corbinstreehouse/LEDDigitalCyrWheel/CyrWheel_PCB/LEDCyrWheel.pdf

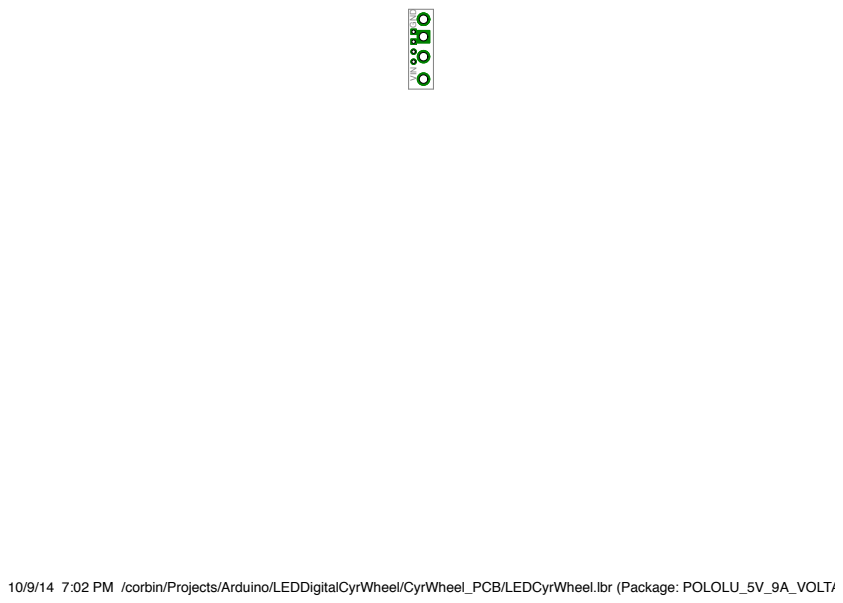
[picture p1: page 1]

10/9/14 7:02 PM /corbin/Projects/Arduino/LEDDigitalCyrWheel/CyrWheel_PCB/LEDCyrWheel.lbr (Package: POLOLU_5V_9A_VOLTAGE_REGULATOR) GND VIN
