corbinstreehouse/LEDDigitalCyrWheel/CyrWheel_PCB/LEDCyrWheel.brd

## EAGLE design CyrWheel_PCB/LEDCyrWheel.brd (2016-02-13)

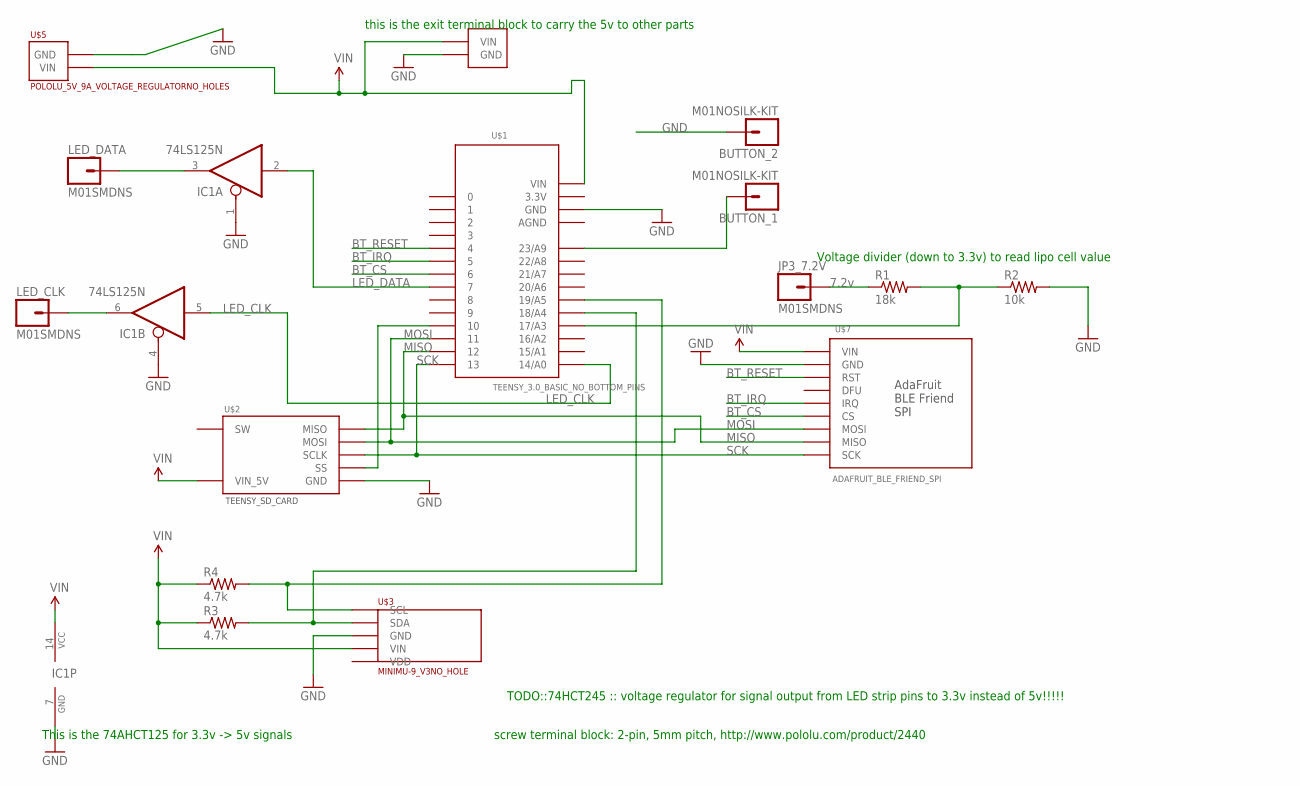
[picture p2: schematic LEDCyrWheel.sch]

Parts:
BUTTON_1, BUTTON_2: M01NOSILK-KIT; 1X01NS-KIT
IC1: 74LS125N; DIL14
JP3_7.2V: M01SMDNS; 1X01NS; VOLTAGE 7.2v
LED_CLK: M01SMDNS; 1X01NS
LED_DATA: M01SMDNS; 1X01NS
R1: 18k; AXIAL-0.4
R2: 10k; AXIAL-0.4
R3, R4: 4.7k; AXIAL-0.4
U$1: TEENSY_3.0_BASIC_NO_BOTTOM_PINS
U$2: TEENSY_SD_CARD
U$3: MINIMU-9_V3NO_HOLE; MINIMU-9_V3_NO_HOLE
U$5: POLOLU_5V_9A_VOLTAGE_REGULATORNO_HOLES; POLOLU_5V_9A_VOLTAGE_REGULATOR_NO_HOLES
U$6: VIN_GND_HOLE; VIN_HOLE
U$7: ADAFRUIT_BLE_FRIEND_SPI

Connections:
3.3V: U$1.3.3V
AGND: U$1.AGND
BT_CS: U$1.6, U$7.CS
BT_IRQ: U$1.5, U$7.IRQ
BT_RESET: U$1.4, U$7.RST
GND: BUTTON_2.1, IC1.1 (OE), IC1.4 (OE), IC1.7 (GND), R2.P$2 (2), U$1.GND, U$2.GND, U$3.GND, U$5.GND, U$5.GND2 (GND), U$5.GND3 (GND), U$6.GND, U$7.GND
LED_CLK: IC1.5 (I), U$1.14/A0
LED_DATA: IC1.2 (I), U$1.7
MISO: U$1.12, U$2.MISO, U$7.MISO
MOSI: U$1.11, U$2.MOSI, U$7.MOSI
unnamed: U$1.10, U$2.SS
unnamed: IC1.6 (O), LED_CLK.1
unnamed: BUTTON_1.1, U$1.23/A9
N_PIN17: R1.P$2 (2), R2.P$1 (1), U$1.17/A3
N_PIN_2_LED_STRIP: IC1.3 (O), LED_DATA.1
SCK: U$1.13, U$2.SCLK, U$7.SCK
SCL: R4.P$2 (2), U$1.19/A5, U$3.SCL
SDA: R3.P$2 (2), U$1.18/A4, U$3.SDA
VIN: IC1.14 (VCC), R3.P$1 (1), R4.P$1 (1), U$1.VIN, U$2.VIN (VIN_5V), U$3.VIN, U$5.VIN, U$5.VIN2 (VIN), U$5.VIN3 (VIN), U$6.VIN, U$7.VIN
VIN_7_2V: JP3_7.2V.1, R1.P$1 (1)

Notes on the sheet:
screw terminal block: 2-pin, 5mm pitch, http://www.pololu.com/product/2440
this is the exit terminal block to carry the 5v to other parts
Voltage divider (down to 3.3v) to read lipo cell value
TODO::74HCT245 :: voltage regulator for signal output from LED strip pins to 3.3v instead of 5v!!!!!
This is the 74AHCT125 for 3.3v -> 5v signals

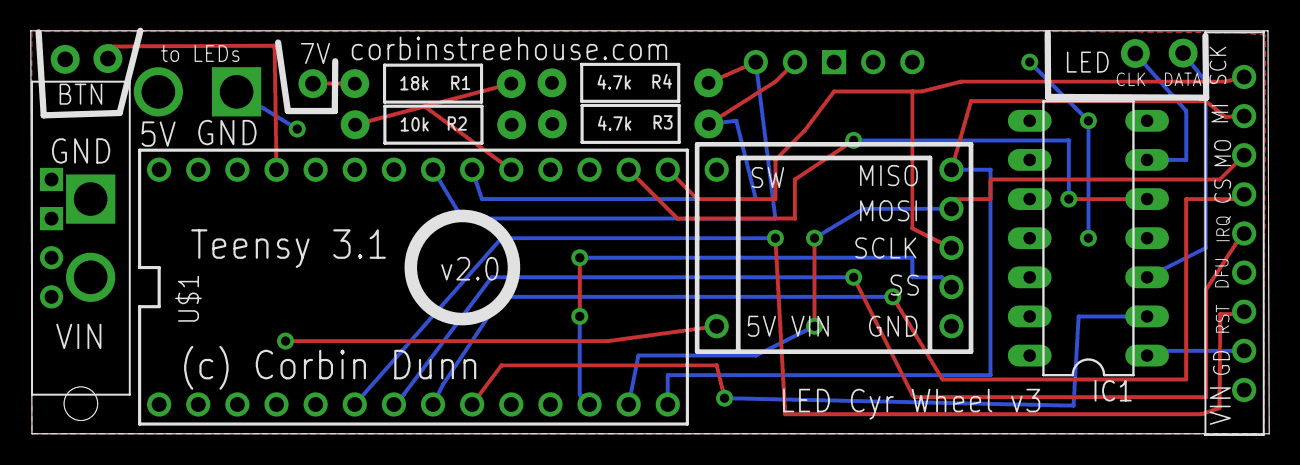
[picture p3: board LEDCyrWheel.brd from above]

Board: 2 copper layers, 80.4 x 26.2 mm, 16 parts (1 on the bottom side), 18 nets.
