corbinstreehouse/LEDDigitalCyrWheel/LEDDigitalCyrWheel/CWPatternSequenceManager.cpp

//
//  CWPatternSequence.cpp
//  LEDDigitalCyrWheel
//
//  Created by corbin dunn on 2/5/14.
//
//

#include "CWPatternSequenceManager.h"
#include "LEDPatterns.h"
#include "LEDDigitalCyrWheel.h"
#include "LEDCommon.h"
#include "SdFat.h"
#include "EEPROM.h"
#if BLUETOOTH
#include "CDWheelBluetoothController.h"
#endif

#define RECORD_INDICATOR_FILENAME "record.txt" // If this file exists, we record data in other files.

#if DEBUG
    #warning "DEBUG Code is on!!"
#include "SdFatUtil.h"
#endif

#define FILENAME_MAX_LENGTH MAX_PATH
#define BURN_INITIAL_STATE 0 // Set to 1 and run once


#if !PATTERN_EDITOR
static const char *g_sequencePath = "/"; // warning..changing this may require different buffers
#endif

char *getExtension(char *filename) {
    char *ext = strchr(filename, '.');
    if (ext) {
        ext++; // go past the dot...
        return ext;
    } else {
        return NULL;
    }
}

CWPatternSequenceManager::CWPatternSequenceManager() : m_ledPatterns(STRIP_LENGTH), m_changeHandler(NULL), m_patternItems(NULL), m_numberOfPatternItems(0)
{
    bzero(&m_rootFileInfo, sizeof(CDPatternFileInfo));
    m_currentPatternItemIndex = -1;
    m_currentFileInfo = NULL;
    m_shouldIgnoreButtonClickWhenTimed = true; // TODO: make this an option per sequence...
    m_timedPatternStartTime = 0;
    ASSERT(sizeof(CDPatternItemHeader) == PATTERN_HEADER_SIZE_v5); // make sure I don't screw stuff up by chaning the size and not updating things again
    ASSERT(sizeof(LEDPatternOptions) == PATTERN_OPTIONS_SIZE_v5); // make sure I don't screw stuff up by chaning the size and not updating things again
    
    m_lowBattery = false;
}

static void freePatternFileInfoAndChildren(CDPatternFileInfo *fileInfo) {
    // Just reset the parent on the default item
    if (fileInfo) {
        if (fileInfo->children) {
            for (int i = 0; i < fileInfo->numberOfChildren; i++) {
                freePatternFileInfoAndChildren(&fileInfo->children[i]);
            }
            free(fileInfo->children);
#if DEBUG
            fileInfo->children = NULL;
#endif
        }
    }
}

static void freePatternFileInfoChildren(CDPatternFileInfo *fileInfo) {
    if (fileInfo) {
        if (fileInfo->children) {
            for (int i = 0; i < fileInfo->numberOfChildren; i++) {
                freePatternFileInfoAndChildren(&fileInfo->children[i]);
            }
            free(fileInfo->children);
            fileInfo->children = NULL; // leave in!!
        }
    }
}

void CWPatternSequenceManager::freeRootFileInfo() {
    freePatternFileInfoAndChildren(&m_rootFileInfo);
    m_currentFileInfo = NULL;
}

#if PATTERN_EDITOR
CWPatternSequenceManager::~CWPatternSequenceManager() {
    m_baseURL = nil;
//    m_patternDirectoryURL = nil;
    freePatternItems();
    freeRootFileInfo();
}
    
void CWPatternSequenceManager::setCyrWheelView(CDCyrWheelView *view) {
    m_ledPatterns.setCyrWheelView(view);
}

void CWPatternSequenceManager::setBaseURL(NSURL *url) {
    m_baseURL = url;
    loadSequencesFromRootDirectory();
}

//void CWPatternSequenceManager::setPatternDirectoryURL(NSURL *url) {
//    m_patternDirectoryURL = url;
//}

#endif

void CWPatternSequenceManager::loadDefaultSequence() {
    DEBUG_PRINTLN("       --- loading default sequence because the name was NULL --- ");
    freePatternItems();

    m_numberOfPatternItems = LEDPatternTypeCount;
    m_shouldIgnoreButtonClickWhenTimed = false;
    
    // After the header each item follows
    m_patternItems = (CDPatternItemHeader *)malloc(m_numberOfPatternItems * sizeof(CDPatternItemHeader));
    
    int i = 0;
    for (int p = LEDPatternTypeMin; p < LEDPatternTypeCount; p++) {
        if (p == LEDPatternTypeDoNothing || p == LEDPatternTypeFadeIn || p == LEDPatternTypeImageReferencedBitmap || p == LEDPatternTypeImageEntireStrip_UNUSED || p == LEDPatternTypeFadeOut || p == LEDPatternTypeCrossfade || p == LEDPatternTypeCount || p == LEDPatternTypeBitmap) {
            continue; // skip a few
        }
        bzero(&m_patternItems[i], sizeof(CDPatternItemHeader));
        
        m_patternItems[i].patternType = (LEDPatternType)p;
        m_patternItems[i].patternEndCondition = CDPatternEndConditionOnButtonClick;
        m_patternItems[i].duration = 2000; //  2 seconds
        m_patternItems[i].patternDuration = 2000;
        // bzero takes care of these
//        m_patternItems[i].patternOptions = 0;
//        m_patternItems[i].dataLength = 0;
        m_patternItems[i].shouldSetBrightnessByRotationalVelocity = 0; // Nope.
//        m_patternItems[i].color = (uint8_t)random(255) << 16 | (uint8_t)random(255) << 8 | (uint8_t)random(255); //        0xFF0000; // red
//        m_patternItems[i].color = (uint8_t)random(255) << 16 | (uint8_t)random(255) << 8 | (uint8_t)random(255); //        0xFF0000; // red
        switch (random(3)) { case 0: m_patternItems[i].color = 0xFF0000; break; case 1: m_patternItems[i].color = 0x00FF00; break; case 2: m_patternItems[i].color = 0x0000FF; break; }
//        m_patternItems[i].dataOffset = 0;
        i++;
    }
    m_numberOfPatternItems = i;
    DEBUG_PRINTF(" --- default pattern count m_numberOfPatternItems: %d\r\n", m_numberOfPatternItems);
    sequenceChanged();
}

static inline bool verifyHeader(CDPatternSequenceHeader *h) {
    // header, and version 0
    DEBUG_PRINTF("checking header, v: %d , expected :%d\r\n", h->version, SEQUENCE_VERSION_v5);
    return h->marker[0] == 'S' && h->marker[1] == 'Q' && h->marker[2] == 'C';
}

void CWPatternSequenceManager::freePatternItems() {
    if (m_patternItems) {
        DEBUG_PRINTLN(" --- free pattern Items");
        for (int i = 0; i < m_numberOfPatternItems; i++) {
            // If it has data, we have to free it
            if (m_patternItems[i].filename) {
                DEBUG_PRINTF("FREEING filename: %s\r\n", m_patternItems[i].filename);
                free(m_patternItems[i].filename);
            }
        }
        free(m_patternItems);
        m_patternItems = NULL;
        m_numberOfPatternItems = 0; // can be removed
    }
    
}

CDPatternItemHeader CWPatternSequenceManager::makeFlashPatternItem(CRGB color) {
    CDPatternItemHeader result;
    result.patternType = LEDPatternTypeBlink;
    result.duration = 500;
    result.patternDuration = 500;
    result.color = color;
    result.patternEndCondition = CDPatternEndConditionOnButtonClick;
    result.filename = NULL;
    return result;
}

void CWPatternSequenceManager::sequenceChanged() {
    // Send the changed note at the end
    sendWheelChanged(CDWheelChangeReasonSequenceChanged);
}

void CWPatternSequenceManager::makeSequenceFlashColor(CRGB color) {
    freePatternItems();
    
    m_numberOfPatternItems = 1;
    m_patternItems = (CDPatternItemHeader *)malloc(sizeof(CDPatternItemHeader) * m_numberOfPatternItems);
    m_patternItems[0] = makeFlashPatternItem(color);

    m_currentPatternItemIndex = 0;
    
    sequenceChanged();
}

// Almost the same as the above..
void CWPatternSequenceManager::makePatternsBlinkColor(CRGB color) {
    m_ledPatterns.setPatternDuration(500);
    m_ledPatterns.setPatternColor(color);
    m_ledPatterns.setPatternType(LEDPatternTypeBlink);
}

void CWPatternSequenceManager::setDynamicPatternType(LEDPatternType type, uint32_t patternDuration, CRGB color) {
    m_dynamicPattern = true;
    
    CDPatternItemHeader header;
    bzero(&header, sizeof(CDPatternItemHeader));
    header.patternType = type;
    header.duration = patternDuration; // Ignored since we are to play till button click
    header.patternDuration = patternDuration;
    header.color = color;
    // I want certain patterns to loop back to the start (here) and repeat after the tick; this allows "single use" patterns to repeat
    if (LEDPatterns::PatternDurationShouldBeEqualToSegmentDuration(type)) {
        header.patternEndCondition = CDPatternEndConditionAfterDuration;
    } else {
        // Just runs indefinitely...
        header.patternEndCondition = CDPatternEndConditionOnButtonClick;
    }
    header.filename = NULL;
    setSingleItemPatternHeader(&header);
    m_currentPatternItemIndex = 0;
    resetStartingTime();
    loadCurrentPatternItem();
}

void CWPatternSequenceManager::setDynamicBitmapPatternType(const char *filename, uint32_t patternDuration, LEDBitmapPatternOptions bitmapOptions) {
    CDPatternItemHeader result;
    bzero(&result, sizeof(CDPatternItemHeader));
    // TODO: might be better to find it in the list!! and then not set m_dynamicPattern!
    m_dynamicPattern = true;
    result.patternType = LEDPatternTypeImageReferencedBitmap;
    result.color = CRGB::Red;
    result.duration = 50;
    result.patternDuration = patternDuration;
    result.patternEndCondition = CDPatternEndConditionOnButtonClick;
    result.patternOptions = LEDPatternOptions(bitmapOptions);
    // filename is later freed automatically when not NULL
    result.filename = (char*)malloc(strlen(filename) + 1);
    strcpy(result.filename, filename);

    setSingleItemPatternHeader(&result);
    m_shouldIgnoreButtonClickWhenTimed = false; // This could be made an option that is settable/dynamically changable.
    m_currentPatternItemIndex = 0;
    
    // TODO: it would be better to find this item in the parent and set it...
    m_dynamicPattern = true;
    resetStartingTime();
    loadCurrentPatternItem();
}

static void _appendFilename(const char *rootDirName, const char *filename, char *fullFilenamePath, size_t size) {
    char *nameLocation = fullFilenamePath;
    // copy the directory for the patterns
    strcpy(nameLocation, rootDirName);
    nameLocation += strlen(rootDirName);
    if (nameLocation[-1] != '/') {
        nameLocation[0] = '/';
        nameLocation++;
    }
    strcpy(nameLocation, filename);
    nameLocation += strlen(filename);
    nameLocation[0] = NULL;
}

void CWPatternSequenceManager::playSequenceWithFilename(const char *filename) {
    // relative filename
    char fullFilenamePath[MAX_PATH];
    _appendFilename(_getRootDirectory(), filename, fullFilenamePath, MAX_PATH);
    
    // open the file
    FatFile sequenceFile = FatFile(fullFilenamePath, O_READ);
#if DEBUG
    DEBUG_PRINTF(" pattern sequence OPENED file:");
    sequenceFile.printName();
    DEBUG_PRINTLN();
#endif
    loadAsSequenceFromFatFile(&sequenceFile);
    sequenceFile.close();
    firstPatternItem();
}

void CWPatternSequenceManager::flashThreeTimes(CRGB color, uint32_t delayAmount) {
    m_ledPatterns.flashThreeTimes(color);
}

// if stackBufferSize == 0, it always allocates (yeah, bad mem mangement techniques)
// This walks to the parent, adds its path, and then adds the child's path to get a complete path
// returns SFN
size_t _recursiveGetFullpathName(const char *rootDirName, const CDPatternFileInfo *fileInfo, char *buffer, size_t size, size_t startingOffset, bool useSFN) {
    if (fileInfo->parent) {
        startingOffset = _recursiveGetFullpathName(rootDirName, fileInfo->parent, buffer, size, startingOffset, useSFN);
    }
    // Add in our path, include seperators
    if (startingOffset > 0 && buffer[startingOffset-1] != '/') {
        buffer[startingOffset] = '/';
        startingOffset++;
        buffer[startingOffset] = 0; // So we can open it...
    }
    
    char *nameLocation = &buffer[startingOffset];
    if (fileInfo->parent == NULL) {
        // Root
        strcpy(nameLocation, rootDirName);
    } else {
        FatFile parentDirectory = FatFile(buffer, O_READ);
        FatFile file;
        if (file.open(&parentDirectory, fileInfo->dirIndex, O_READ)) {
    #if DEBUG
//            DEBUG_PRINTF("  opened and copying the name. buffer: %s, name: ", buffer);
//            file.printName();
//            DEBUG_PRINTF("\r\n");
    #endif
            if (useSFN) {
                if (!file.getSFN(nameLocation)) {
                    // errors?
                }
            } else {
                if (!file.getName(nameLocation, size-startingOffset)) {
                    // errors?
                }
            }
            file.close();
        } else {
            DEBUG_PRINTF("  open failed!!!!!\r\n");
        }
        parentDirectory.close();
    }
    return startingOffset + strlen(nameLocation);
}


static void _getFullpathName(const char *rootDirName, const CDPatternFileInfo *fileInfo, char *buffer, size_t size, bool useSFN = true) {
    buffer[0] = 0;
//    DEBUG_PRINTF(" start to get name for dir: %d \r\n", fileInfo->dirIndex);
    _recursiveGetFullpathName(rootDirName, fileInfo, buffer, size, 0, useSFN);
//    DEBUG_PRINTF(" computed filename: %s\r\n", buffer);
}

void CWPatternSequenceManager::loadAsBitmapFileInfo(CDPatternFileInfo *fileInfo) {
    CDPatternItemHeader result;
    result.patternType = LEDPatternTypeBitmap; // Easy testing: LEDPatternTypeTheaterChase;
    result.color = CRGB::Red;
    result.duration = 50;
    bool isPOV = false;
    // POV patterns will be as fast as they can go (value == 0)... but that looks terrible for non POV patterns
    // Harcode certain directory names as being POV
    // Load our parent directory name to find out
    uint32_t defaultDuration = 32; // slowish
    if (fileInfo->parent) {
        // I could probably do this faster..
        char filenameBuffer[FILENAME_MAX_LENGTH];
        _getFullpathName(_getRootDirectory(), fileInfo->parent, filenameBuffer, FILENAME_MAX_LENGTH);
        FatFile parentDirectory = FatFile(filenameBuffer, O_READ);
        if (parentDirectory.getName(filenameBuffer, FILENAME_MAX_LENGTH)) {
            // corbin, other dirs!! pixels, etc.
            
            if (strcmp(filenameBuffer, "Pictures") == 0 || strcmp(filenameBuffer, "Figures") == 0) {
                defaultDuration = 0; // POV duration
                isPOV = true;
            }
        }
    }
    
    result.patternDuration = defaultDuration;
    result.patternEndCondition = CDPatternEndConditionOnButtonClick;
    bool shouldInterpolateToNextRow = false; // TODO:?? default value for these??
    result.patternOptions = LEDPatternOptions(LEDBitmapPatternOptions(false, m_defaultShouldStretchBitmap, shouldInterpolateToNextRow, isPOV));
    result.filename = NULL;
    
    setSingleItemPatternHeader(&result); // Sends sequenceChanged
    m_shouldIgnoreButtonClickWhenTimed = false; // This could be made an option that is settable/dynamically changable.
}

uint32_t CWPatternSequenceManager::getCurrentPatternSpeed() {
    CDPatternItemHeader *header = getCurrentItemHeader();
    return header ? header->patternDuration : 0;
}

void CWPatternSequenceManager::setCurrentPatternColor(CRGB color) {
    CDPatternItemHeader *header = getCurrentItemHeader();
    if (header) {
        if (header->color != color) {
            header->color = color;
            m_ledPatterns.setPatternColor(color);
            sendWheelChanged(CDWheelChangeReasonPatternChanged);
        }
    }
}

void CWPatternSequenceManager::setCurrentPattenOptions(LEDPatternOptions options) {
    CDPatternItemHeader *header = getCurrentItemHeader();
    if (header) {
        if (header->patternOptions.raw != options.raw) {
            header->patternOptions = options;
            m_ledPatterns.setPatternOptions(options);
            sendWheelChanged(CDWheelChangeReasonPatternChanged);
        }
    }
}

void CWPatternSequenceManager::setCurrentPattenShouldSetBrightnessByRotationalVelocity(bool value) {
    CDPatternItemHeader *header = getCurrentItemHeader();
    if (header) {
        if (header->shouldSetBrightnessByRotationalVelocity != value) {
            header->shouldSetBrightnessByRotationalVelocity = value;
            updateBrightness();
            sendWheelChanged(CDWheelChangeReasonPatternChanged);
        }
    }
}


void CWPatternSequenceManager::setCurrentPatternSpeed(uint32_t speedInMs) {
    CDPatternItemHeader *header = getCurrentItemHeader();
    if (header) {
        if (header->patternDuration != speedInMs) {
            header->patternDuration = speedInMs;
            m_ledPatterns.setPatternDuration(speedInMs);
            sendWheelChanged(CDWheelChangeReasonPatternChanged);
        }
    }
}


void CWPatternSequenceManager::loadAsSequenceFromFatFile(FatFile *sequenceFile) {
    freePatternItems();
    m_dynamicPattern = false;
    // This is reading the file format I created..
    // Header first
    CDPatternSequenceHeader patternHeader;
    if (sequenceFile->available()) {
        sequenceFile->read((char*)&patternHeader, sizeof(CDPatternSequenceHeader));
    } else {
        bzero(&patternHeader, sizeof(CDPatternSequenceHeader));
    }
    
    // Verify it
    if (verifyHeader(&patternHeader)) {
        if (patternHeader.version == SEQUENCE_VERSION_v5) {
            // Free existing stuff
            ASSERT(m_patternItems == NULL);
            
            m_numberOfPatternItems = patternHeader.patternCount;
            m_shouldIgnoreButtonClickWhenTimed = patternHeader.ignoreButtonForTimedPatterns;
            
            ASSERT(sizeof(CDPatternItemHeader) == PATTERN_HEADER_SIZE_v5); // MAKE SURE IT IS RIGHT..
            DEBUG_PRINTF("now reading %d items, headerSize: %d\r\n", m_numberOfPatternItems, sizeof(CDPatternItemHeader));
            
            // After the header each item follows
            m_patternItems = (CDPatternItemHeader *)calloc(m_numberOfPatternItems, sizeof(CDPatternItemHeader));
            //            memset(m_patternItems, 0, numBytes); // shouldn't be needed, but do it anyways
            
            for (int i = 0; i < m_numberOfPatternItems; i++ ){
                DEBUG_PRINTF("reading item %d\r\n", i);
                sequenceFile->read((char*)&m_patternItems[i], sizeof(CDPatternItemHeader));
                DEBUG_PRINTF("Header, type: %d, duration: %d, patternDuration %d\r\n", m_patternItems[i].patternType, m_patternItems[i].duration, m_patternItems[i].patternDuration);
                // Verify it
                bool validData = m_patternItems[i].patternType >= LEDPatternTypeMin && m_patternItems[i].patternType < LEDPatternTypeCount;
                ASSERT(validData);
                if (!validData) {
                    // fill it in with something..
                    m_patternItems[i] = makeFlashPatternItem(CRGB::Red);
                } else {
                    // I guess a 0 duration is okay..it will just blink it..
                    // After the header, is the (optional) image data
                    
                    // Read in the filename, if it is there..
                    uint32_t filenameLength = m_patternItems[i].filenameLength; // We use a union, so we have to save the length first
                    if (filenameLength > 0) {
                        ASSERT(filenameLength <= MAX_PATH);
                        size_t filenameSize = sizeof(char) * filenameLength + 1; // Space for the name plus one for the NULL
                        m_patternItems[i].filename = (char*)malloc(filenameSize);
                        // Read into the filename buffer we allocated
                        sequenceFile->read(m_patternItems[i].filename, filenameSize);
                    } else {
                        m_patternItems[i].filename = NULL; //
                    }
                }
            }
            DEBUG_PRINTLN("DONE");
        } else {
            // We don't support this version... flash purple
            DEBUG_PRINTLN("wrong version!");
            makeSequenceFlashColor(CRGB::Purple);
        }
    } else {
        // Bad data...flash yellow
        DEBUG_PRINTLN("bad sequence file!");
        makeSequenceFlashColor(CRGB::Yellow);
    }
    sequenceChanged();
}

void CWPatternSequenceManager::loadAsSequenceFileInfo(CDPatternFileInfo *fileInfo) {
    ASSERT(fileInfo->patternFileType == CDPatternFileTypeSequenceFile);
    
    char fullFilenamePath[MAX_PATH];
    _getFullpathName(_getRootDirectory(), fileInfo, fullFilenamePath, MAX_PATH);
    
    DEBUG_PRINTF("  loadAsSequenceFileInfo: %d at %s\r\n", fileInfo->dirIndex, fullFilenamePath);
    
    // open the file
    FatFile sequenceFile = FatFile(fullFilenamePath, O_READ);
#if DEBUG
    DEBUG_PRINTF(" OPENED file:");
    sequenceFile.printName();
    DEBUG_PRINTLN();
#endif

    loadAsSequenceFromFatFile(&sequenceFile);

    sequenceFile.close();
}

void CWPatternSequenceManager::loadSequenceInMemoryFromFatFile(FatFile *sequenceFile) {
    m_currentPatternItemIndex = -1; // Set this first so that the sendWheelChanged doesn't allow the caller to acccess anything
    loadAsSequenceFromFatFile(sequenceFile);
    firstPatternItem();
}

void CWPatternSequenceManager::changeToDirectory(const char *dir) {
    // TODO: implement.. right now we go to root..
    m_currentFileInfo = NULL;
    _ensureCurrentFileInfo();
}

void CWPatternSequenceManager::loadFileInfo(CDPatternFileInfo *fileInfo) {
    ASSERT(fileInfo != NULL);
    ASSERT(fileInfo->patternFileType != CDPatternFileTypeDirectory);

//    m_currentPatternItemsAreDynamic = false;
    // in case we get the root for some reason (shouldn't happen!)
    if (fileInfo == &m_rootFileInfo) {
        loadDefaultSequence();
        return;
    }
    
    freePatternItems();
    
    m_dynamicPattern = false;
    
    switch (fileInfo->patternFileType) {
        case CDPatternFileTypeSequenceFile: {
            loadAsSequenceFileInfo(fileInfo);
            break;
        }
        case CDPatternFileTypeBitmapImage: {
            loadAsBitmapFileInfo(fileInfo);
            break;
        }
        case CDPatternFileTypeDefaultSequence: {
            loadDefaultSequence();
            break;
        }
        default: {
            makeSequenceFlashColor(CRGB::Red); // error of some sort
            sequenceChanged();
            break;
        }
    }
}

// TODO: rewrite this
//bool CWPatternSequenceManager::deleteSequenceAtIndex(int index) {
//    bool result = false;
//    int lastIndex = _currentSequenceIndex;
//    if (index >= 0 && index < _numberOfAvailableSequences) {
//        char *name = getSequenceNameAtIndex(index);
//        if (name != g_defaultFilename) {
//#define STACK_BUFFER_SIZE 32
//            char stackBuffer[STACK_BUFFER_SIZE];
//            char *filename = getFullpathName(name, stackBuffer, STACK_BUFFER_SIZE);
//            DEBUG_PRINTF("deleting %s\n", filename);
//            
//            result = SD.remove(filename);
//            
//            if (filename != stackBuffer) {
//                free(filename);
//            }
//            if (lastIndex >= index) {
//                lastIndex--;
//            }
//        }
//    }
//    
//    if (result) {
//        loadSequencesFromRootDirectory();
//        if (_currentSequenceIndex != lastIndex) {
//            loadCurrentSequence();
//        }
//    }
//    return result;
//}

void CWPatternSequenceManager::loadFirstSequence() {
    
    setCurrentSequenceAtIndex(0);
//    _currentSequenceIndex = 0;
//    loadCurrentSequence(); // validates the index here
}

CDPatternFileInfo *CWPatternSequenceManager::_findFirstLoadableChild(CDPatternFileInfo *fileInfo, bool forwards) {
    if (fileInfo->children == NULL && fileInfo->patternFileType == CDPatternFileTypeDirectory) {
        // Lazy load of children
        loadPatternFileInfoChildren(fileInfo);
    }
    if (fileInfo->children) {
        if (forwards) {
            for (int i = 0; i < fileInfo->numberOfChildren; i++) {
                CDPatternFileInfo *potentialChild = _findFirstLoadable(&fileInfo->children[i], forwards);
                if (potentialChild) {
                    return potentialChild;
                }
            }
        } else {
            for (int i = fileInfo->numberOfChildren - 1; i >= 0; i--) {
                CDPatternFileInfo *potentialChild = _findFirstLoadable(&fileInfo->children[i], forwards);
                if (potentialChild) {
                    return potentialChild;
                }
            }
        }
    }
    return NULL;
}

CDPatternFileInfo *CWPatternSequenceManager::_findFirstLoadable(CDPatternFileInfo *fileInfo, bool forwards) {
    if (fileInfo->patternFileType != CDPatternFileTypeDirectory) {
        return fileInfo; // This item is loadable
    }
    return _findFirstLoadableChild(fileInfo, forwards);
}

CDPatternFileInfo *CWPatternSequenceManager::_findNextLoadableChild(CDPatternFileInfo *fromChild, bool forwards) {
    CDPatternFileInfo *result = NULL;
    CDPatternFileInfo *parent = fromChild->parent;
    if (parent) {
        // Go through the parent's children, finding the first loadable one
        int end, inc;
        if (forwards) {
            end = parent->numberOfChildren;
            inc = 1;
        } else {
            end = -1;
            inc = -1;
        }
        int start = fromChild->indexInParent + inc;

        for (int i = start; i != end; i += inc) {
            result = _findFirstLoadable(&parent->children[i], forwards);
            if (result) {
                return result;
            }
        }
        // We went through all the parent's children, and nothing is loadable. Go to our parent's next sibling
        result = _findNextLoadableChild(parent, forwards);
    } else {
        // We have reached the root; this should always have something to return; if it doesn't, we return the root, which should be loadable..
        result = _findFirstLoadableChild(fromChild, forwards);
        if (result == NULL) {
            DEBUG_PRINTLN("************* No loadable children?????");
            result = parent;
        }
    }
    return result;
}

void CWPatternSequenceManager::loadNextDirectory() {
    m_currentFileInfo = _findNextLoadableChild(m_currentFileInfo->parent, true);
    loadCurrentSequence();
}

void CWPatternSequenceManager::loadPriorDirectory() {
    m_currentFileInfo = _findNextLoadableChild(m_currentFileInfo->parent, false);
    loadCurrentSequence();
}


void CWPatternSequenceManager::_ensureCurrentFileInfo() {
    if (m_currentFileInfo == NULL) {
        m_currentFileInfo = _findFirstLoadableChild(&m_rootFileInfo, true);
        if (m_currentFileInfo == NULL) {
            m_currentFileInfo = &m_rootFileInfo;
        }
    }
}

void CWPatternSequenceManager::setCurrentSequenceAtIndex(int index) {
    _ensureCurrentFileInfo();
    if (m_currentFileInfo) {
        CDPatternFileInfo *parent = m_currentFileInfo->parent;
        if (parent && index < parent->numberOfChildren) {
            m_currentFileInfo = &parent->children[index];
        }
    }
    loadCurrentSequence();
}

void CWPatternSequenceManager::setSingleItemPatternHeader(CDPatternItemHeader *header) {
//    m_currentFileInfo = NULL;
//    m_currentPatternItemsAreDynamic = true;

    freePatternItems();
    m_numberOfPatternItems = 1;

    m_patternItems = (CDPatternItemHeader *)malloc(sizeof(CDPatternItemHeader) * m_numberOfPatternItems);
    m_patternItems[0] = *header;
    
    sequenceChanged();
}

void CWPatternSequenceManager::loadCurrentSequence() {
    // Validate the current info
    _ensureCurrentFileInfo();
    
    // If it is still NULL, load the default info.
    loadFileInfo(m_currentFileInfo);
    
    firstPatternItem();
}

void CWPatternSequenceManager::getFilenameForPatternFileInfo(const CDPatternFileInfo *fileInfo, char *buffer, size_t bufferSize) {
    _getFullpathName(_getRootDirectory(), fileInfo, buffer, bufferSize, false);
}

void CWPatternSequenceManager::getCurrentPatternFileName(char *buffer, size_t bufferSize, bool useSFN) {
    _ensureCurrentFileInfo();
    if (m_dynamicPattern) {
        strcpy(buffer, "Dynamic Sequence");
    } else if (m_currentFileInfo->patternFileType == CDPatternFileTypeDefaultSequence) {
        strcpy(buffer, "Default Sequence");
    } else {
        _getFullpathName(_getRootDirectory(), m_currentFileInfo, buffer, bufferSize, useSFN);
    }
}


#if SD_CARD_SUPPORT

bool CWPatternSequenceManager::initSDCard() {
    DEBUG_PRINTLN("initSD Card");
//#if 0 // DEBUG
////    delay(2000);
//    DEBUG_PRINTLN("END: really slow pause... and doing SD init....");
//#endif
//    pinMode(SD_CARD_CS_PIN, OUTPUT); // Any pin can be used as SS, but it must remain low
//    digitalWrite(SD_CARD_CS_PIN, LOW);
// ^ done way earlier
    
    bool result = m_sd.begin(SD_CARD_CS_PIN, SPI_FULL_SPEED); //  was SPI_HALF_SPEED
    
    int i = 0;
#if DEBUG
    if (!result) {
        DEBUG_PRINTLN("SD Card full speed SPI init failed...trying again (slower doesn't work..)...");
    }
#endif
    while (!result) {
        result = m_sd.begin(SD_CARD_CS_PIN, SPI_HALF_SPEED); // was SPI_HALF_SPEED...
        i++;
        if (i == 1) {
            break; // give it 3 more chances??.. (it is slow to init for some reason...)
        }
    }
#if DEBUG
    if (result) {
        DEBUG_PRINTLN("SD Card Initialized");
    } else {
        DEBUG_PRINTLN("SD Card initialization failed!");
    }
    
#endif
    return result;
}

#endif

bool CWPatternSequenceManager::initStrip() {
    m_ledPatterns.begin();
    m_ledPatterns.setBrightness(m_brightness);
    
    return true;
}

void CWPatternSequenceManager::burnInitialStateInEEPROM() {
#if BURN_INITIAL_STATE
    EEPROM.write(EEPROM_SHOULD_SHOW_BOOT_PROGRESS, 1); // true
    EEPROM.write(EEPROM_BRIGHTNESS_ADDRESS, DEFAULT_BRIGHTNESS);
    EEPROM.write(BLUETOOTH_EEPROM_SERVICES_ARE_REGISTERED, 0); // False
    EEPROM.write(ORIENT_EEPROM_MIN_MAX_IS_SAVED_ADDRESS, 0);
    EEPROM.write(EEPROM_SHOULD_STRETCH_BITMAP, 0);
    
#else
#if DEBUG
    m_ledPatterns.flashThreeTimes(CRGB::Red); // Don't call this..
#endif
#endif
}

void CWPatternSequenceManager::loadSettings() {
#if BURN_INITIAL_STATE
    burnInitialStateInEEPROM();
#endif
    // initial state burn in ability.. uncomment and run once.
    // Maybe reset to the default if the button is held down?
    m_brightness = EEPROM.read(EEPROM_BRIGHTNESS_ADDRESS);

    // Make sure we don't overflow the bitset
    m_shouldShowBootProgress = EEPROM.read(EEPROM_SHOULD_SHOW_BOOT_PROGRESS) ? 1 : 0;
    // TODO: set this!!
    m_defaultShouldStretchBitmap = false; // EEPROM.read(EEPROM_SHOULD_STRETCH_BITMAP) ? 1 : 0;
    
    if (m_brightness < MIN_BRIGHTNESS || m_brightness > MAX_BRIGHTNESS) {
        m_brightness = DEFAULT_BRIGHTNESS;
        DEBUG_PRINTF("SAVED BRIGHTNESS setting to default..out of band\r\n");
    } else {
        DEBUG_PRINTF("SAVED BRIGHTNESS: %d\r\n", m_brightness);
    }
}

void CWPatternSequenceManager::setShouldShowBootProgress(bool value) {
    if (m_shouldShowBootProgress != value) {
        m_shouldShowBootProgress = value;
        EEPROM.write(EEPROM_SHOULD_SHOW_BOOT_PROGRESS, m_shouldShowBootProgress ? 1 : 0);
    }
}


const char *CWPatternSequenceManager::_getRootDirectory() {
#if PATTERN_EDITOR
    if (m_baseURL != nil) {
        return [m_baseURL fileSystemRepresentation];
    } else {
        return "/var/tmp/.patternEditor/"; // Just something that doesn't exist
    }
#else
    return g_sequencePath;
#endif
}

const char *CWPatternSequenceManager::_getPatternDirectory() {
#if PATTERN_EDITOR
    if (m_patternDirectoryURL != nil) {
        return [m_patternDirectoryURL fileSystemRepresentation];
    } else {
        ASSERT(false); // we need it .
        return "/Patterns"; // ?
    }
#else
    // Customizable?
    return g_sequencePath;
#endif
}


static void _setupFileInfo(CDPatternFileInfo *info, CDPatternFileInfo *parent, int indexInParent, uint16_t dirIndex, CDPatternFileType type) {
    info->dirIndex = dirIndex;
    info->patternFileType = type;
    info->children = NULL;
    info->numberOfChildren = 0;
    info->parent = parent;
    info->indexInParent = indexInParent;
}



void CWPatternSequenceManager::loadSequencesFromRootDirectory() {
    freeRootFileInfo();
    
    _setupFileInfo(&m_rootFileInfo, NULL, -1, 0, CDPatternFileTypeDirectory);
    loadPatternFileInfoChildren(&m_rootFileInfo);
    incBootProgress();

    // check for the record filename when loading the root
    m_sd.chdir(_getRootDirectory());
    if (m_sd.exists(RECORD_INDICATOR_FILENAME)) {
        m_shouldRecordData = true;
        m_ledPatterns.flashThreeTimes(CRGB(30,30,30));
    }
    
    loadFirstSequence();
}

void CWPatternSequenceManager::reloadRootSequences() {
    loadPatternFileInfoChildren(&m_rootFileInfo);
    loadFirstSequence();
}

void CWPatternSequenceManager::loadPatternFileInfoChildren(CDPatternFileInfo *parent) {
    ASSERT(parent);
    bool isRoot = isRootFileInfo(parent);
    if (m_sdCardWorks && parent->patternFileType == CDPatternFileTypeDirectory) {
        DEBUG_PRINTF("loadPatternFileInfoChildren start\r\n");

// corbin, better name getting..
#define STACK_BUFFER_SIZE PATH_COMPONENT_BUFFER_LEN
        char filenameBuffer[FILENAME_MAX_LENGTH];
        //  parent directory needs a larger buffer, and does dynamic malloc if needed
        _getFullpathName(_getRootDirectory(), parent, filenameBuffer, FILENAME_MAX_LENGTH);
#undef STACK_BUFFER_SIZE
        DEBUG_PRINTF("loadPatternFileInfoChildren: %s\r\n", filenameBuffer);
        
 
        // #define SHORT_FILENAME_LENGTH 13 // 12 + 1 for NULL, and needs to be 256 or so for the simulator!!
//        char shortFilenameBuffer[SHORT_FILENAME_LENGTH]; // 8.3 Short file name (SFN)
        char *shortFilenameBuffer = filenameBuffer; // reuse the same buffer for now. NOTE: This must be larger than 13 for the sim, which needs the full path stored!!

        CDPatternFileInfo *children = NULL;
        int potentialChildrenSize = 0;
#define INITIAL_CHILDREN_SIZE 16 // 32 entries at a time. too much? extra memory?
#define CHILDREN_GROW_SIZE 16 // 16 entries at a time. too much? extra memory?
        int childCount = 0;

        bool foundPatternFile = false;
        {
            FatFile directoryFile = FatFile(filenameBuffer, O_READ);
            FatFile file;
            while (file.openNext(&directoryFile, O_READ)) {
                CDPatternFileType patternFileType = CDPatternFileTypeUnknown;
                if (file.isHidden()) {
                    // Ignore hidden files
                } else if (file.isDir()) {
                    patternFileType = CDPatternFileTypeDirectory;
                } else {
                    if (file.getSFN(shortFilenameBuffer)) {
                        char *ext = getExtension(shortFilenameBuffer);
                        if (ext) {
                            if (strcasecmp(ext, SEQUENCE_FILE_EXTENSION) == 0) {
                                patternFileType = CDPatternFileTypeSequenceFile;
                                foundPatternFile = true;
                            } else if (strcasecmp(ext, BITMAP_FILE_EXTENSION) == 0) {
                                patternFileType = CDPatternFileTypeBitmapImage;
                            }
                        }
                    }
                }
                
                if (patternFileType != CDPatternFileTypeUnknown) {
    #if DEBUG
//                    DEBUG_PRINTF("Found file/folder: ");
                    file.printName();
                    DEBUG_PRINTLN("");
    #endif

                    // Save it!
                    if (children == NULL) {
                        potentialChildrenSize = INITIAL_CHILDREN_SIZE;
                        children = (CDPatternFileInfo *)malloc(sizeof(CDPatternFileInfo) * potentialChildrenSize);
                    } else if (childCount >= potentialChildrenSize) {
                        DEBUG_PRINTF("reallocing children, childCount: %d, free: %d\r\n", childCount, SdFatUtil::FreeRam());
                        potentialChildrenSize += CHILDREN_GROW_SIZE;
                        children = (CDPatternFileInfo *)realloc(children, sizeof(CDPatternFileInfo) * potentialChildrenSize);
                        DEBUG_PRINTF("  -- done children, childCount: %d, free: %d\r\n", childCount, SdFatUtil::FreeRam());
                    }
                    _setupFileInfo(&children[childCount], parent, childCount, file.dirIndex(), patternFileType);

                    childCount++;
                }
                file.close();
            }
            directoryFile.close();
        }
        
        
        DEBUG_PRINTF("Found %d sequences/files/dirs on SD Card\r\n", childCount);

        // Add one for the default sequence
        if (isRoot) {
            // Sort it so the patterns are at the start
            if (foundPatternFile) {
                DEBUG_PRINTF("Sorting, because found a pattern file\r\n", childCount);
                bool didAMove = false;
                for (int i = 0; i < childCount; i++) {
                    // We want sequence files at the start
                    if (children[i].patternFileType == CDPatternFileTypeSequenceFile) {
                        continue; // It is good..
                    } else {
                        // Not a sequence file; if there are any sequence files after us, move them before us.
                        bool done = true;
                        for (int j = i + 1; j < childCount; j++) {
                            if (children[j].patternFileType == CDPatternFileTypeSequenceFile) {
                                // We found one..we want to swap it to where i is located and move everything starting at i to j one to the right.
                                CDPatternFileInfo tmp = children[j];
                                // Move them one to the right; this overrites the item at j that is saved
                                memmove(&children[i+1], &children[i], (j - i)*sizeof(CDPatternFileInfo));
                                // Now put j in this spot
                                children[i] = tmp;
                                // i is now good; we can repeat again...
                                done = false;
                                didAMove = true;
                                break;
                            }
                        }
                        if (done) {
                            break; // We hit the end of the array and didn't move so we are done.
                        }
                    }
                }
                // Fixup the indexes in the parent with another pass
                if (didAMove) {
                    for (int i = 0; i < childCount; i++) {
                        children[i].indexInParent = i;
                    }
                }
            }
            DEBUG_PRINTF("Okay, sorted\r\n", childCount);

            
            // Make space for it, and set it up
            if (children == NULL) {
                potentialChildrenSize = 1;
                children = (CDPatternFileInfo *)malloc(sizeof(CDPatternFileInfo) * potentialChildrenSize);
            } else if (childCount >= potentialChildrenSize) {
                potentialChildrenSize += 1;
                children = (CDPatternFileInfo *)realloc(children, sizeof(CDPatternFileInfo) * potentialChildrenSize);
            }
            // setup the default item for the root item
            _setupFileInfo(&children[childCount], parent, childCount, -1/*not used*/, CDPatternFileTypeDefaultSequence);
            childCount++;
            
            // Sort so that we have pattern files at the start before folders..
        }
        
        freePatternFileInfoChildren(parent);
        // realloc array to save memory if we have a lot of extra space.. I'm not sure if this is worth it..
        if (children && childCount <= (potentialChildrenSize /*+2*/)) {
            children = (CDPatternFileInfo *)realloc(children, sizeof(CDPatternFileInfo) * childCount);
        }
        
        parent->children = children;
        parent->numberOfChildren = childCount;
        DEBUG_PRINTF("Done loading\r\n", childCount);

    } else if (isRoot) {
        // Add one child..for the default sequence
        parent->numberOfChildren = 1;
        parent->children = (CDPatternFileInfo *)malloc(sizeof(CDPatternFileInfo));
        _setupFileInfo(&parent->children[0], parent, 0, -1/*not used*/, CDPatternFileTypeDefaultSequence);
    } else {
        parent->numberOfChildren = 0;
        parent->children = NULL;
    }


}

void CWPatternSequenceManager::setupBootProgress() {
    if (m_shouldShowBootProgress) {
        m_bootProgress = .01;
        m_ledPatterns.setBrightness(40);
    }
}

void CWPatternSequenceManager::incBootProgress()  {
    if (m_shouldShowBootProgress) {
//        DEBUG_PRINTLN(" ... boot ...");
        m_bootProgress += 0.01;
        m_ledPatterns.showProgress(m_bootProgress, CRGB::Green);
    }
}

void CWPatternSequenceManager::init(bool buttonIsDown) {
    DEBUG_PRINTLN("::init");
    m_shouldRecordData = false;
    
    // Settings need to be loaded before we init the strip (saves/restores brightness)
    loadSettings();
    
    DEBUG_PRINTLN("init strip");
    initStrip();
    DEBUG_PRINTLN("done init strip, starting to init SD Card");
    
#if BURN_INITIAL_STATE
    // Warn the user THAT THIS IS ON!
    m_ledPatterns.flashThreeTimes(CRGB::Red);
#endif
    
    setupBootProgress();
    
#if ACCELEROMETER
    DEBUG_PRINTLN("init orientation");
    initOrientation();
#endif
    incBootProgress();

#if  SD_CARD_SUPPORT
    m_sdCardWorks = initSDCard();
    DEBUG_PRINTLN("done init sd card");
    incBootProgress();
#else
    m_sdCardWorks = false;
#endif
    
    loadSequencesFromRootDirectory();
}

#if ACCELEROMETER

void CWPatternSequenceManager::startRecordingData() {
    if (!m_orientation.isSavingData()) {
        m_ledPatterns.flashThreeTimes(CRGB::Green);
        m_orientation.beginSavingData();
    }
}

void CWPatternSequenceManager::endRecordingData() {
    if (m_orientation.isSavingData()) {
        m_orientation.endSavingData();
        m_ledPatterns.flashThreeTimes(CRGB::Blue);
    }
}

void CWPatternSequenceManager::startCalibration() {
    // Go into calibration mode for the accell
    if (!m_orientation.isCalibrating()) {
        m_orientation.beginCalibration();
        // Override the default sequence to blink
        makePatternsBlinkColor(CRGB::Pink);
    }
}

void CWPatternSequenceManager::endCalibration() {
    DEBUG_PRINTLN("about to end!");
    if (m_orientation.isCalibrating()) {
        m_orientation.endCalibration();
        // Flash to let you know it is done
        m_ledPatterns.flashThreeTimes(CRGB::Green);
        firstPatternItem();
    } else {
        DEBUG_PRINTLN("not calibration!!!");

    }
}

void CWPatternSequenceManager::cancelCalibration() {
    DEBUG_PRINTLN("about to cancel!");
    if (m_orientation.isCalibrating()) {
        m_orientation.cancelCalibration();
    }
}

bool CWPatternSequenceManager::initOrientation() {
    DEBUG_PRINTLN("init orientation");
    bool result = m_orientation.init(); // TODO: return if it failed???
    
    DEBUG_PRINTLN("DONE init orientation");
    
    return result;
}

#endif

void CWPatternSequenceManager::loadNextSequence() {
    DEBUG_PRINTLN("loadNextSequence");
    _ensureCurrentFileInfo();
    m_currentFileInfo = _findNextLoadableChild(m_currentFileInfo, true);
    loadCurrentSequence();
}

void CWPatternSequenceManager::restartCurrentSequence() {
    firstPatternItem();
}

void CWPatternSequenceManager::loadPriorSequence() {
    DEBUG_PRINTLN("loadPriorSequence");
    _ensureCurrentFileInfo();
    m_currentFileInfo = _findNextLoadableChild(m_currentFileInfo, false);
    loadCurrentSequence();
}

void CWPatternSequenceManager::buttonClick() {
#if ACCELEROMETER
    if (m_orientation.isCalibrating()) {
        m_orientation.endCalibration();
        firstPatternItem();
    } else
#endif
    if (isPaused()) {
        // Only the BT stuff can pause us... make the button click start us up again..
        play();
    } else {
        // TODO: Maybe a "start on button click" option...in addition to m_shouldIgnoreButtonClickWhenTimed
        // Then, I could just call the next command..
        
        // bitmap images just go to the next sequence..
        if (currentFileInfoIsBitmapImage()) {
            loadNextSequence();
        } else if (m_shouldIgnoreButtonClickWhenTimed) {
            // Only go to next if it isn't timed; this helps me avoid switching the pattern accidentally when stepping on it.
            CDPatternItemHeader *itemHeader = getCurrentItemHeader();
            if (itemHeader == NULL || itemHeader->patternEndCondition == CDPatternEndConditionOnButtonClick) {
                nextPatternItem();
            }
        } else {
            nextPatternItem();
        }
    }
}

void CWPatternSequenceManager::buttonLongClick() {
    if (m_shouldRecordData) {
#if ACCELEROMETER
        if (!m_orientation.isSavingData()) {
            startRecordingData();
        } else {
            endRecordingData();
        }
#endif
    } else {
        if (currentFileInfoIsBitmapImage()) {
            loadNextDirectory();
        } else if (m_shouldIgnoreButtonClickWhenTimed) {
            // Only go to next if it isn't timed; this helps me avoid switching the pattern accidentally when stepping on it.
            CDPatternItemHeader *itemHeader = getCurrentItemHeader();
            if (itemHeader == NULL || itemHeader->patternEndCondition == CDPatternEndConditionOnButtonClick) {
                loadNextSequence();
            }
        } else {
            loadNextSequence();
        }
    }
}

void CWPatternSequenceManager::process() {
    
//    float time = millis()-m_timedPatternStartTime;
//    time = time / 1000.0;
//    Serial.println(time);
#if ACCELEROMETER
    m_orientation.process();
    if (m_orientation.isCalibrating()) {
        // Show the flashing, and return
        m_ledPatterns.show();
        return;
    }
#endif

    if (m_numberOfPatternItems == 0) {
        DEBUG_PRINTLN("No pattern items to show!");
        m_ledPatterns.flashThreeTimes(CRGB::Yellow);
        delay(1000);
        return;
    }
    
    updateBrightness();

    // First, always do one pass through the update of the patterns; this updates the time
    m_ledPatterns.show();
    
    if (!isPaused() && (m_currentPatternItemIndex != -1)) {
        // This updates how much time has passed since the pattern started and how many full intervals have run through.
        // See if we should go to the next pattern
        CDPatternItemHeader *itemHeader = &m_patternItems[m_currentPatternItemIndex];
        // See if we should go to the next pattern if enough time passed
        if (itemHeader->patternEndCondition == CDPatternEndConditionAfterDuration) {
            // subtract out how much time has passed from our initial pattern, and when we actually started the first timed pattern. This gives more accurate timings.
            uint32_t timePassed = millis() - m_timedUsedBeforeCurrentPattern - m_timedPatternStartTime;
            if (timePassed >= itemHeader->duration) {
                autoNextPatternItem();
            }
        } else {
            // It is waiting for some other condition before going to the next pattern (button click is the only condition now)
            // But if we are in the simulator, we do some more work
#if PATTERN_EDITOR
            uint32_t timePassed = millis() - m_timedUsedBeforeCurrentPattern - m_timedPatternStartTime;
            if (timePassed >= itemHeader->duration) {
                // reset our start time and ping the position changed
                m_timedPatternStartTime = millis() - m_timedUsedBeforeCurrentPattern;
                sendWheelChanged(CDWheelChangeReasonPlayheadPositionChanged);
            }
#endif
        }
    }
}


void CWPatternSequenceManager::updateBrightness() {
    if (m_lowBattery) {
        // Harcoded to have a low brightness..but is this low enough?
        m_ledPatterns.setBrightness(25);
    } else {
        CDPatternItemHeader *itemHeader = getCurrentItemHeader();
        if (itemHeader && itemHeader->shouldSetBrightnessByRotationalVelocity) {
#if ACCELEROMETER
            uint8_t brightness = m_orientation.getRotationalVelocityBrightness(m_ledPatterns.getBrightness());
#else
            uint8_t brightness = m_brightness;
#endif
    #if DEBUG
            if (brightness < 10){
                DEBUG_PRINTLN("low brightness from velocity based updateBrightness");
            }
    #endif
            
            m_ledPatterns.setBrightness(brightness);
        } else {
            m_ledPatterns.setBrightness(m_brightness);
        }
    }
}

void CWPatternSequenceManager::setBrightness(uint8_t brightness) {
    if (m_brightness != brightness) {
#if DEBUG
        CDPatternItemHeader *itemHeader = getCurrentItemHeader();
        DEBUG_PRINTF("old bright: %d, new: %d, itemHeader->shouldSetBrightnessByRotationalVelocity: %d\r\n", m_brightness, brightness, itemHeader ? itemHeader->shouldSetBrightnessByRotationalVelocity : 0);
#endif
        m_brightness = brightness;
        updateBrightness();
        sendWheelChanged(CDWheelChangeReasonBrightnessChanged);
        EEPROM.write(EEPROM_BRIGHTNESS_ADDRESS, m_brightness);
        if (isPaused()) {
            // show it right now but without any other state..
            m_ledPatterns.internalShow();
        }
    }
}

void CWPatternSequenceManager::setLowBatteryWarning() {
    m_lowBattery = true;
    updateBrightness();
#if BLUETOOTH
     // TODO: maybe turn off bluetooth to save energy??
#endif
}

void CWPatternSequenceManager::firstPatternItem() {
    m_currentPatternItemIndex = 0;
    resetStartingTime();
    loadCurrentPatternItem();
}

void CWPatternSequenceManager::rewind() {
    if (m_currentPatternItemIndex == 0) {
        resetStartingTime();
        loadCurrentPatternItem();
    } else if (m_currentPatternItemIndex > 0) {
        uint32_t position = tickCountInMS() - m_timedPatternStartTime;
        // some threshold of allowing it to rest
        uint32_t timePassed = position - m_timedUsedBeforeCurrentPattern;
        uint32_t minToGo = isPaused() ? 50 : 500;
        if (timePassed > minToGo) { // half a second...
            // Okay reset
            m_timedPatternStartTime = tickCountInMS() - m_timedUsedBeforeCurrentPattern;
#if PATTERN_EDITOR
            sendWheelChanged(CDWheelChangeReasonPlayheadPositionChanged);
#endif
            loadCurrentPatternItem();
            // show the current state in case we are paused
            m_ledPatterns.forceShow();
        } else {
            // prior..we are basically at the start
            priorPatternItem();
        }
    } else {
        priorPatternItem(); // fallback..
    }
}

void CWPatternSequenceManager::priorPatternItem() {
    m_currentPatternItemIndex--;
    if (m_currentPatternItemIndex < 0) {
        // loop to the end
        m_currentPatternItemIndex = m_numberOfPatternItems - 1; // m_currentPatternItemIndex could be negative if there are no patterns
    }
    // Keep track of the prior that passed; if m_currentPatternItemIndex is 0, we reset in loadCurrentPatternItem
    if (m_currentPatternItemIndex == 0) {
        resetStartingTime();
    } else if (m_currentPatternItemIndex > 0) {
        // Just manually reset m_timedUsedBeforeCurrentPattern; this isn't used often so who cares if it iterates
        m_timedUsedBeforeCurrentPattern = 0;
        for (int i = 0; i < m_currentPatternItemIndex; i++) {
            m_timedUsedBeforeCurrentPattern += m_patternItems[i].duration;
        }
        m_timedPatternStartTime = tickCountInMS() - m_timedUsedBeforeCurrentPattern;
        // show the current state in case we are paused
        m_ledPatterns.forceShow();
#if PATTERN_EDITOR
        sendWheelChanged(CDWheelChangeReasonPlayheadPositionChanged);
#endif   
    }
    
    loadCurrentPatternItem();
}

void CWPatternSequenceManager::nextPatternItem() {
    m_currentPatternItemIndex++;
    if (m_currentPatternItemIndex <= 0 || m_currentPatternItemIndex >= m_numberOfPatternItems) {
        // Loop back or the initial time
        m_currentPatternItemIndex = 0;
        resetStartingTime();
    } else {
        // m_currentPatternItemIndex is >= 1
        if (m_autoNextPatternItem) {
            // We are just going to the next and can inc our time easily...
            m_timedUsedBeforeCurrentPattern += m_patternItems[m_currentPatternItemIndex - 1].duration;
            // If the actual time passed isn't this long...well, make it so..i think this was to fix up some slight timing issues
            if (!isPaused() && (tickCountInMS() - m_timedPatternStartTime) < m_timedUsedBeforeCurrentPattern) {
                m_timedPatternStartTime = tickCountInMS() - m_timedUsedBeforeCurrentPattern; // go back in the past!
            }
        } else {
            // Slower computation method (just like prior)
            m_timedUsedBeforeCurrentPattern = 0;
            for (int i = 0; i < m_currentPatternItemIndex; i++) {
                m_timedUsedBeforeCurrentPattern += m_patternItems[i].duration;
            }
            m_timedPatternStartTime = tickCountInMS() - m_timedUsedBeforeCurrentPattern;
            // show the current state in case we are paused
            m_ledPatterns.forceShow();
        }
#if PATTERN_EDITOR
        sendWheelChanged(CDWheelChangeReasonPlayheadPositionChanged);
#endif
    }
    
    loadCurrentPatternItem();
}

void CWPatternSequenceManager::resetStartingTime() {
    m_timedPatternStartTime = tickCountInMS();
    m_timedUsedBeforeCurrentPattern = 0;
#if PATTERN_EDITOR
    sendWheelChanged(CDWheelChangeReasonPlayheadPositionChanged);
    m_ledPatterns.forceShow();
#endif
}

#if PATTERN_EDITOR

void CWPatternSequenceManager::setPlayheadPositionInMS(uint32_t position) {
    // back it up to pretend the start time was in the past
    // NOTE: setDurationPassed also fixes up the paused time, if paused, so we use millis()
    uint32_t now = millis();
    m_timedPatternStartTime = now - position;
    // Based on that, setup m_timedUsedBeforeCurrentPattern and m_currentPatternItemIndex
    m_timedUsedBeforeCurrentPattern = 0;
    if (m_numberOfPatternItems == 0) {
        m_currentPatternItemIndex = -1;
    } else {
        m_currentPatternItemIndex = 0;
        for (int i = 0; i < m_numberOfPatternItems; i++) {
            uint32_t timePassed = m_timedUsedBeforeCurrentPattern + m_patternItems[i].duration;
            if (timePassed >= position) {
                break; // We are within this pattern
            } else {
                m_timedUsedBeforeCurrentPattern += m_patternItems[i].duration;
                m_currentPatternItemIndex++;
            }
        }
        // TODO: maybe cap if it is passed everything?
        CDPatternItemHeader *itemHeader = &m_patternItems[m_currentPatternItemIndex];
        loadPatternItemHeaderIntoPatterns(itemHeader);
        
        // Figure out how far into the current pattern we are and assign its position based on that
        uint32_t positionInCurrentPattern = position - m_timedUsedBeforeCurrentPattern;
        m_ledPatterns.setDurationPassed(positionInCurrentPattern, now);
        // show the current state in case we are paused
        m_ledPatterns.show();
    }
}

uint32_t CWPatternSequenceManager::getPlayheadPositionInMS() {
    return tickCountInMS() - m_timedPatternStartTime;
}


#endif

void CWPatternSequenceManager::loadPatternItemHeaderIntoPatterns(CDPatternItemHeader *itemHeader) {
    ASSERT(itemHeader != NULL);
    
    // Reset the stuff based on the new header
    m_ledPatterns.setPatternType(itemHeader->patternType);
    
    // For some, we want the duration to be equal to the item's entire run/length
    if (LEDPatterns::PatternDurationShouldBeEqualToSegmentDuration(itemHeader->patternType)) {
        m_ledPatterns.setPatternDuration(itemHeader->duration);
    } else {
        // The duration affects the "speed" about how fast it repeats..I need to rename this to speed or something better...
        m_ledPatterns.setPatternDuration(itemHeader->patternDuration);
    }
    
    m_ledPatterns.setPatternColor(itemHeader->color);
    m_ledPatterns.setPatternOptions(itemHeader->patternOptions);
    // Assume it is the current file..
    
#if SD_CARD_SUPPORT
    if (itemHeader->patternType == LEDPatternTypeBitmap) {
        // The filename is the bitmap we are set to play back
        char fullFilenamePath[MAX_PATH];
        _getFullpathName(_getRootDirectory(), m_currentFileInfo, fullFilenamePath, MAX_PATH);
#if 0 // DEBUG
        DEBUG_PRINTF("Bitmap: %s\r\n", fullFilenamePath);
#endif
        m_ledPatterns.setBitmapFilename(fullFilenamePath);
        
        // If the bitmap was invalid, then we flip to a flashing sequence
        if (m_ledPatterns.getBitmap() == NULL || !m_ledPatterns.getBitmap()->getIsValid()) {
            // Invalid bitmap; flash magenta
            makePatternsBlinkColor(CRGB::DarkMagenta);
        }
    } else if (itemHeader->patternType == LEDPatternTypeImageReferencedBitmap || itemHeader->patternType == LEDPatternTypeImageEntireStrip_UNUSED) {
        
        // Make sure we have a filename!
        if (itemHeader->filename) {
            char fullFilenamePath[MAX_PATH];
            _appendFilename(_getPatternDirectory(), itemHeader->filename, fullFilenamePath, MAX_PATH);
            
#if 0 // DEBUG
            DEBUG_PRINTF("Referenced bitmap: %s\r\n", fullFilenamePath);
#endif
            
            m_ledPatterns.setBitmapFilename(fullFilenamePath);
            
            // Check if it is valid..
            if (m_ledPatterns.getBitmap() == NULL || !m_ledPatterns.getBitmap()->getIsValid()) {
                // Invalid bitmap; flash magenta
                makePatternsBlinkColor(CRGB::DarkMagenta);
            }
        } else {
            // programming or data error, no filename
            makePatternsBlinkColor(CRGB::DarkMagenta);
        }
    } else {
        m_ledPatterns.setBitmapFilename(NULL);
    }
#endif
    
    
#if 0 // DEBUG
    DEBUG_PRINTF("----- loadPatternItemHeaderIntoPatterns (patternType: %d): %d of %d, dur: %d patDur: %d\r\n", itemHeader->patternType, m_currentPatternItemIndex + 1, m_numberOfPatternItems, itemHeader->duration, itemHeader->patternDuration);
#endif
    
    // Crossfade patterns need to know the next one!
    if (itemHeader->patternType == LEDPatternTypeCrossfade) {
        // Load the next... and set its color (cross fade doesn't use it)
        CDPatternItemHeader *nextItemHeader = getNextItemHeader();
        if (nextItemHeader->patternType != LEDPatternTypeCrossfade) {
            m_ledPatterns.setNextPatternType(nextItemHeader->patternType);
            m_ledPatterns.setPatternColor(nextItemHeader->color);
        } else {
            // We can't crossfade to crossfade; pick red as an error
            m_ledPatterns.setNextPatternType(LEDPatternTypeSolidColor);
            m_ledPatterns.setPatternColor(CRGB::Red);
        }
    }
    
}

void CWPatternSequenceManager::loadCurrentPatternItem() {
    // The simulator could have 0 items (but I should make it not!)
    if (m_numberOfPatternItems == 0) {
        m_currentPatternItemIndex = -1;
        makePatternsBlinkColor(CRGB::Red);
        return;
    }
    
    // Ensure we always have good data
    // TODO: I'm now expecting the caller to do this, but do it here just to check
    if (m_currentPatternItemIndex < 0 || m_currentPatternItemIndex >= m_numberOfPatternItems) {
        ASSERT(false);
        m_currentPatternItemIndex = 0;
        resetStartingTime();
    }
    
    // m_currentPatternItemIndex is validated, so directly grab it from the array
    CDPatternItemHeader *itemHeader = &m_patternItems[m_currentPatternItemIndex];
    loadPatternItemHeaderIntoPatterns(itemHeader);
    
#if ACCELEROMETER
    m_orientation.setFirstPass(true); // why do I need this??
#endif
    
    // TODO: aggregate these into one BT send!
    sendWheelChanged(CDWheelChangeReasonPatternChanged);
    // toDO: Only sent state changed when needed
    sendWheelChanged(CDWheelChangeReasonStateChanged);
}

void CWPatternSequenceManager::processCommand(CDWheelCommand command) {
    // The commands are handled slightly differently depending on the current pattern we are playing.
    switch (command) {
        case CDWheelCommandNextPattern: {
            // Bitmaps can't really do a next item; there is only one, so they do the next sequence in the directory
            if (currentFileInfoIsBitmapImage()) {
                loadNextSequence();
            } else {
                nextPatternItem();
            }
            break;
        }
        case CDWheelCommandPriorPattern: {
            if (currentFileInfoIsBitmapImage()) {
                loadPriorSequence();
            } else {
                priorPatternItem();
            }
            break;
        }
        case CDWheelCommandNextSequence: {
            if (currentFileInfoIsBitmapImage()) {
                loadNextDirectory();
            } else {
                loadNextSequence();
            }
            break;
        }
        case CDWheelCommandPriorSequence: {
            if (currentFileInfoIsBitmapImage()) {
                loadPriorDirectory();
            } else {
                loadPriorSequence();
            }
            break;
        }
        case CDWheelCommandRestartSequence: {
            restartCurrentSequence();
            break;
        }
#if ACCELEROMETER
        case CDWheelCommandStartCalibrating: {
            startCalibration();
            break;
        }
        case CDWheelCommandEndCalibrating: {
            endCalibration();
            break;
        }
        case CDWheelCommandCancelCalibrating: {
            cancelCalibration();
            break;
        }
        case CDWheelCommandStartSavingGyroData: {
            startRecordingData();
            break;
        }
        case CDWheelCommandEndSavingGyroData: {
            endRecordingData();
            break;
        }
#endif
        case CDWheelCommandPlay: {
            play();
            break;
        }
        case CDWheelCommandPause: {
            pause();
            break;
        }
            
        default: {
            // Ignore unknown things
        }
    }
}

void CWPatternSequenceManager::play() {
    if (m_ledPatterns.isPaused()) {
        // Reset m_timedPatternStartTime based on the amount of time we were paused
        uint32_t now = millis();
        // we might wrap...
        uint32_t pausedTime = m_ledPatterns.getPauseTime();
        if (now > pausedTime) {
            uint32_t timePassed = now - pausedTime;
            m_timedPatternStartTime += timePassed;
        } else {
            // wrap..
        }
        m_ledPatterns.play(); // this unpauses us
        sendWheelChanged(CDWheelChangeReasonStateChanged);
    }
}

void CWPatternSequenceManager::pause() {
    if (!m_ledPatterns.isPaused()) {
        m_ledPatterns.pause();
        sendWheelChanged(CDWheelChangeReasonStateChanged);
    }
}

CDWheelState CWPatternSequenceManager::getWheelState() {
    CDWheelState result = CDWheelStateNone;
    if (!m_ledPatterns.isPaused()) {
        result = result | CDWheelStatePlaying;
    }
    if (m_currentPatternItemIndex != -1) {
        if (currentFileInfoIsBitmapImage()) {
            // slightly different behavior to enumerate images in the directories...
            if (m_rootFileInfo.numberOfChildren > 1) {
                result = result | CDWheelStatePriorPatternAvailable;
                result = result | CDWheelStateNextPatternAvailable;
            }
        } else {
            if (m_numberOfPatternItems > 1) {
                if (m_currentPatternItemIndex > 0) {
                    result = result | CDWheelStatePriorPatternAvailable;
                }
                if (m_currentPatternItemIndex < m_numberOfPatternItems+1) {
                    result = result | CDWheelStateNextPatternAvailable;
                }
            }
        }
    }

    // sequences always available..if we have more than one!
    if (m_rootFileInfo.numberOfChildren > 1) {
        result = result | CDWheelStateNextSequenceAvailable;
        result = result | CDWheelStatePriorSequenceAvailable;
    }
    return result;
}

#if ACCELEROMETER
void CWPatternSequenceManager::writeOrientationData(Stream *stream) {
    m_orientation.writeOrientationData(stream);
}
#endif
