corbinstreehouse/LEDDigitalCyrWheel/(commit log)

2014-01-17 Initial checkin. It compiled a file for teensy 3.1!
2014-01-17 Better code completion setup for teensy3
2014-01-18 button and state
2014-01-20 use other stuff…
2014-02-12 Massive refactoring to move LED patterns to a separate file. Not tested yet..but compiles.
2014-02-13 Abstraction fixes to i can compile in MacOS
    [CDPatternData.h, CWPatternSequenceManager.cpp, CWPatternSequenceManager.h, LEDDigitalCyrWheel.cpp, LEDDigitalCyrWheel.h]
2014-02-26 Better color rainbow implementation. Fix compilation of hardware side.
    [LEDDigitalCyrWheel.cpp]
2014-03-01 debug/fix fading out and in. and loading SD card.
    [CDPatternData.h, CWPatternSequenceManager.cpp, CWPatternSequenceManager.h]
2014-03-01 Implement press and hold to switch sequences.
2014-03-01 fmod now found…use it
2014-03-01 LSM303 Accelerometer testing
2014-03-07 Fix event sending happening while processing hold
    [Button.cpp]
2014-03-07 implement voltage reading, etc
2014-03-31 bottom glow fixes..and wave multiple pattern
    [CDPatternData.h, CWPatternSequenceManager.cpp, CWPatternSequenceManager.h]
2014-04-12 rework of buffer reading
    [CDPatternData.h, CWPatternSequenceManager.cpp, CWPatternSequenceManager.h, LEDDigitalCyrWheel.h]
2014-04-12 debugging sd card read problems
    [CWPatternSequenceManager.cpp, LEDDigitalCyrWheel.cpp]
2014-04-19 Initial pass at an orientation class for accel/gyro readings.
2014-04-20 Update the board platform tag to be 1.05 // 105 for arduino
2014-04-20 Better organization of flags to match what the Arduino IDE does
2014-05-03 EEPROM reading of calibration data.
2014-05-11 remove #define ACCELEROMETER_SUPPORT 1 // not in the sim..
2014-05-30 some more work to try out the oct library; it conflict w/my pin uses...
2014-06-01 New LED Patterns class / abstraction.
2014-06-04 Rework of the code to move LEDPatterns to a new shareable reusable class
    [CDOrientation.cpp, CDOrientation.h, CWPatternSequenceManager.cpp, CWPatternSequenceManager.h, LEDCommon.h, LEDDigitalCyrWheel.cpp, LEDDigitalCyrWheel.h]
2014-06-04 fast LED update
2014-06-04 Move to LED Patterns project.
2014-06-04 Revert "Move to LED Patterns project."
    This reverts commit 415637c889b4a74561723b3203a5d02ef325d7d5.
    [LEDDigitalCyrWheel.cpp]
2014-09-25 Gyro tweaks to not fail on init. Add more options to make the button not get hit.
    [CDOrientation.cpp, CDOrientation.h, CDPatternData.h, CWPatternSequenceManager.cpp, CWPatternSequenceManager.h, LEDCommon.h, LEDDigitalCyrWheel.cpp, LEDDigitalCyrWheel.h]
2014-09-26 optional makefile mod to use LEDPatterns / FastLED and OctoWS2811 for testing
2014-09-26 Up the min voltage back up to 7.4; it wasn't hitting it, and just turning off!
2014-09-30 I really am using pin 10. For reals, for SD card. This was probably the source of my problems….(or at least one part of many). Also, back to doing the battery ref check off…as it is clipped for now.
    [LEDDigitalCyrWheel.cpp, LEDDigitalCyrWheel.h]
2014-10-11 Updated voltage reading
2014-10-11 Custom PCB files
    [LEDCyrWheel.brd, LEDCyrWheel.sch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]
2014-10-14 define local path lengths incase I switch libraries.
2014-10-14 Do spi init
2014-10-14 Teensyduino update to 1.20
2014-10-14 Updated LEDPatterns ref
2015-11-19 Make it compile with Arduino 1.6.6 and Teensy 1.2.6
2015-12-09 Initial bitmap support (need to move lazy bitmap to LED patterns)
2015-12-10 moved to LED Patterns
2015-12-13 Fix some crashes etc
    [CDPatternData.h, CWPatternSequenceManager.cpp, CWPatternSequenceManager.h]
2015-12-25 Updated arduino IDE use
2016-01-17 Move the reset pin to 4 to be able to use pin 7
2016-01-17 Updates to using APA102 leds
2016-01-17 Fast LED hack implementation
2016-01-18 LED speed notes
2016-01-18 duration shouldn't reset when it is 0; 0 means as fast as it can go
    [CWPatternSequenceManager.cpp]
2016-01-23 ref up for LED Patterns
2016-01-30 Work around for flash of LEDs on start with APA102
2016-01-30 better intialial children size to avoid grow
    [CWPatternSequenceManager.cpp]
2016-02-01 PCB design work
    [LEDCyrWheel.brd, LEDCyrWheel.sch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]
2016-02-01 Updated PCB design for new leds
    [LEDCyrWheel.brd, LEDCyrWheel.sch]
2016-02-02 Updated PCB
    [LEDCyrWheel.brd]
2016-02-05 fixup code completion stuff by setting the compiler used in the project
    [CDPatternData.h, CDPatternSequenceManagerShared.h, CDWheelBluetoothShared.h]
2016-02-13 PCB fixes
    [LEDCyrWheel.brd, LEDCyrWheel.sch]
2016-02-14 #if ACCELEROMETER
2016-04-01 my new LED strip length
2016-04-01 trying to fix SPI access to be faster.
    [CyrWheelLEDPatterns.cpp]
2016-04-08 BT init logic w/button down
2016-04-11 Log the starting voltage
2016-04-15 Some renames and timing rework
    [CWPatternSequenceManager.cpp, CWPatternSequenceManager.h]
2016-04-15 Don't ignore voltage
2016-04-15 Timing rework for better direct offset assignment
    [CWPatternSequenceManager.cpp, CWPatternSequenceManager.h, CyrWheelLEDPatterns.cpp]
2016-04-25 set the correction to LED strip
    [CyrWheelLEDPatterns.cpp]
2016-05-07 slow down the speed (corruption) back to 7mhz, and remove color correction for now
    [CyrWheelLEDPatterns.cpp]
2018-04-25 Init only if the button is down for BT
2018-12-08 Absolute paths for teensy location
